chetan1126/DD_ROBOCON_Projects/PCB_Design/R1_esp32_view.png

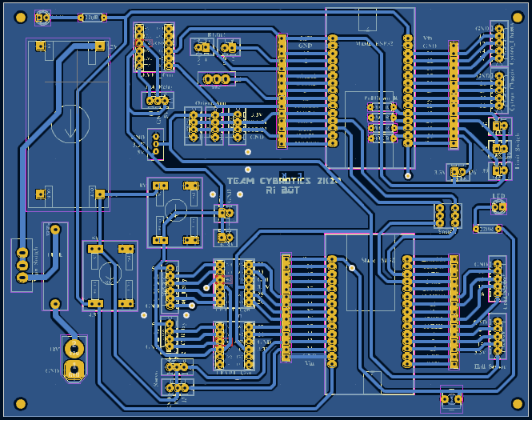
PCB_Design/R1_esp32_view.png
