chetan1126/DD_ROBOCON_Projects/PCB_Design/R1_ESP32_3d_view.png

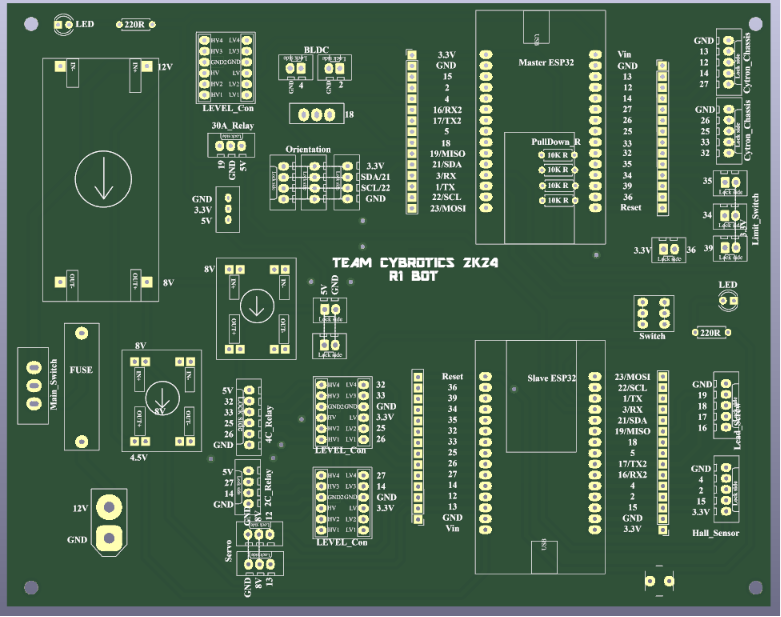
PCB_Design/R1_ESP32_3d_view.png
