chetan1126/DD_ROBOCON_Projects/PCB_Design/R1_ESP32_schematic_view.pdf

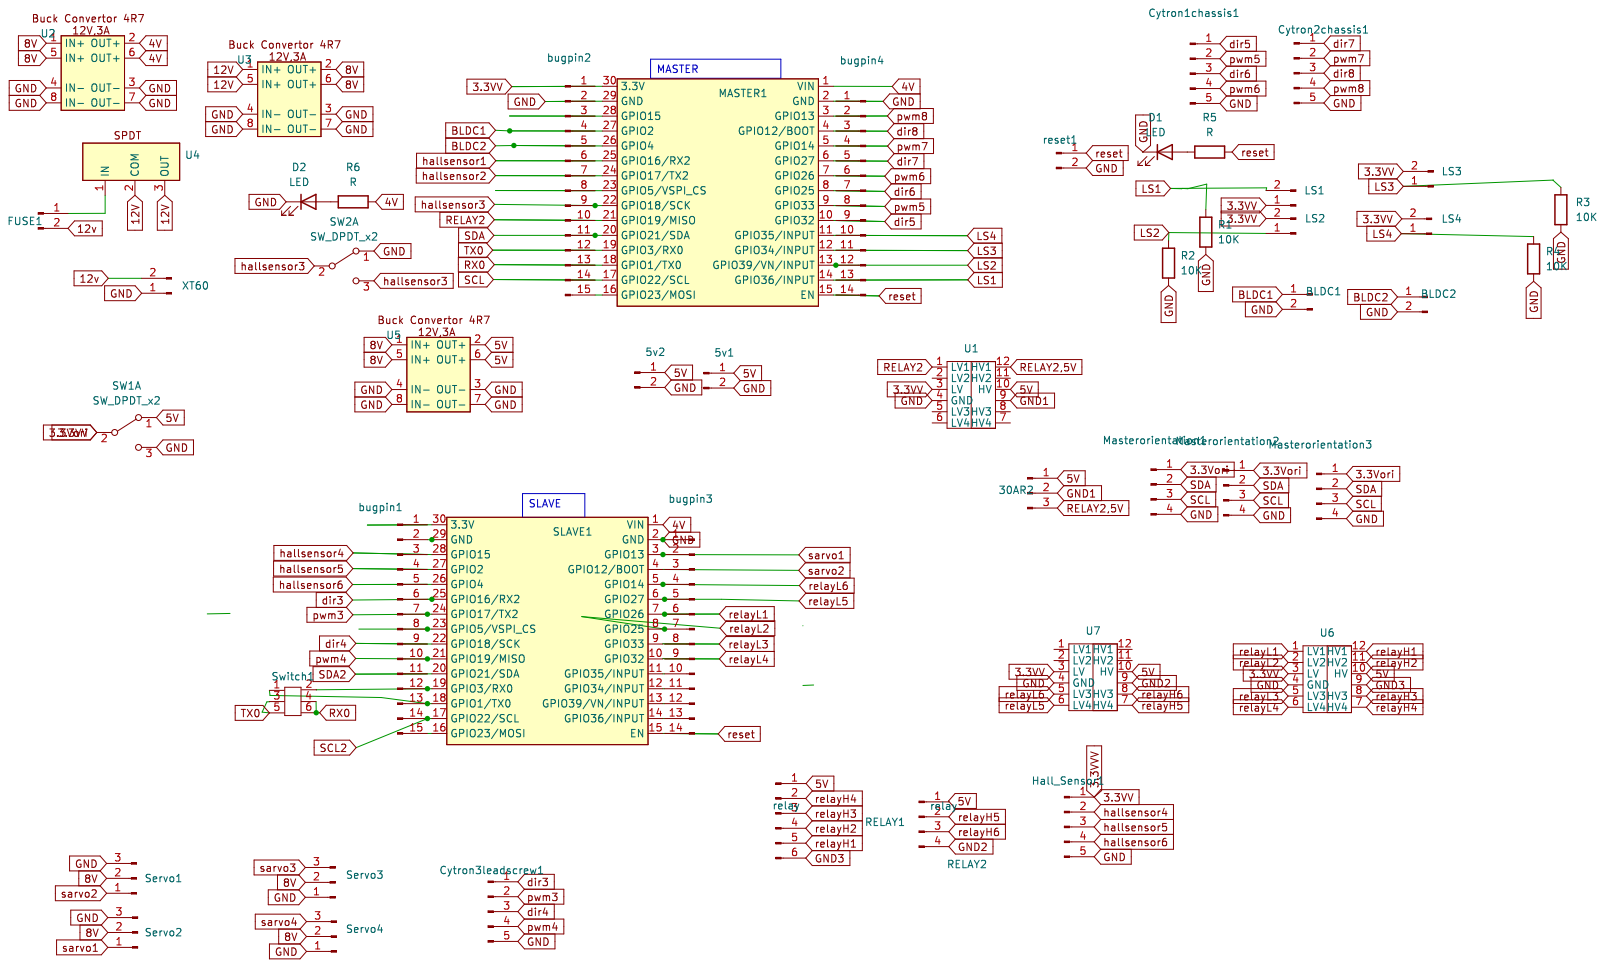
[picture p39: page 1]
