chetan1126/DD_ROBOCON_Projects/Code/R1/ESP32_Cytron_Motor_Driver/examples/PWM_DIR_DUAL/PWM_DIR_DUAL.ino

#include "ESP_Motor_Driver.h"


// Configure the motor driver.
CytronMD motor1(PWM_DIR, 15, 2, 0, 30000, 8); 
CytronMD motor2(PWM_DIR, 12, 27, 1, 30000, 8); 


// The setup routine runs once when you press reset.
void setup() {
  
}


// The loop routine runs over and over again forever.
void loop() {
  motor1.setSpeed(-128);
  motor2.setSpeed(-128);
  delay(1000);
  motor1.setSpeed(225);
  motor2.setSpeed(225);
  delay(1000);
  motor1.setSpeed(128);
  motor2.setSpeed(128);
  delay(1000);
  motor1.setSpeed(-225);
  motor2.setSpeed(-225);
  delay(1000);
}
